PrototypeFive/MLFR_Sensor/README.MD

# MLFR_Sensor 
## (Micro_Laser_Filament_Runout_Sensor)

MLFR_Sensor is 3D printer filament runout sensor based on VCNT2030 Reflective Optical sensor.\
It uses microscopic IR laser and a phototransistor to detect transparent and less reflective materials.

**Supply voltage:** 5V

**Logic:** Active Low

### Print the enclosure:
Use 0.2mm layer height, 2-3 perimeters and 30% infill.<br/>
Print enclosure base with black PLA or PETG.<br/>
Position vertical, like on image. It's important, because the geometry inside diffuses the laser.<br/>
There is a sacrifical layer to be removed.<br/>
Print cover with transparent PLA or PETG, position flat on bed.<br/> 

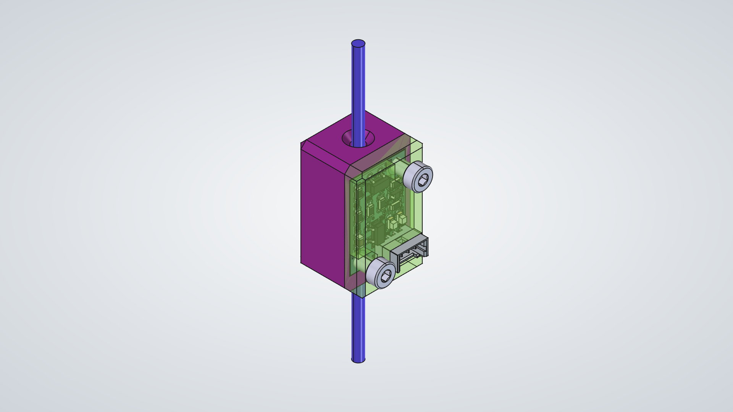
[picture p1: enclosure_2.png]
sensor


License: CERN-OHL-S version 2
