PrototypeFive/MLFR_Sensor/enclosure/enclosure.FCStd

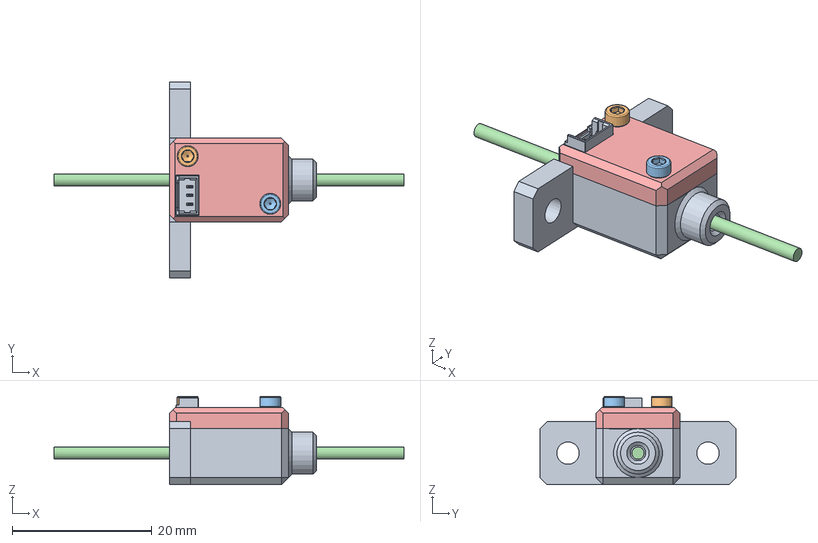
[picture p3: CAD file, 2026-01-30]
enclosure/enclosure.FCStd
50.0 x 28.0 x 12.6 mm
base
M1.6x6-Screw
M1.6x6-Screw002
filament
cover
R_0603_1608Metric
R_0603_1608Metric001
R_0603_1608Metric002
SOT-23
LED_0603_1608Metric
R_0603_1608Metric003
D_0603_1608Metric
R_0603_1608Metric004
SOT-001
LED_0603_1608Metric001
R_0603_1608Metric005
CI44-BASE-DIP_3
CI44-T-DIP
CI44-T-DIP001
CI44-T-DIP002
C_0603_1608Metric
alt_2_copper
alt_2_pad
alt_2_via
alt_2_silkscreen
alt_2_soldermask
alt_2_PCB
