PrototypeFive/MLFR_Sensor/pcb/alt_2.pdf

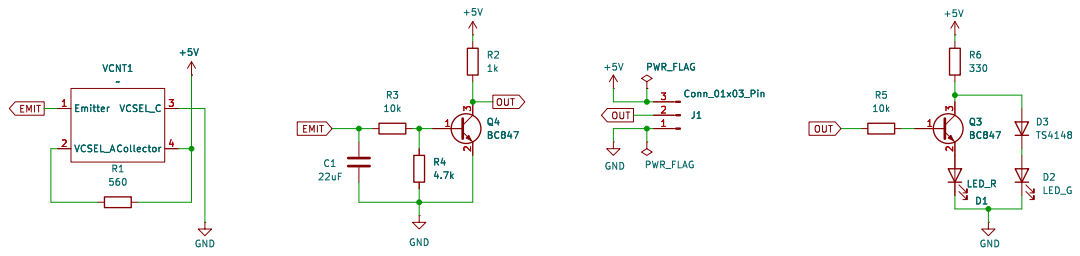
[picture p4: page 1]

CERN-OHL-S-2.0
Id: 1/1 Title: MLFR_Sensor File: alt_2.kicad_sch Sheet: / www.prototypefive.com
