PrototypeFive/MLFR_Sensor/pcb/alt_2.kicad_pcb

## KiCad design pcb/alt_2.kicad_pcb (2026-01-30)

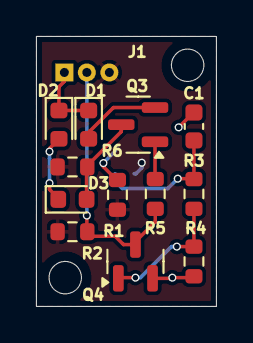
[picture p5: board alt_2.kicad_pcb from above]

Board: 2 copper layers, 10.0 x 15.0 mm, 14 parts (1 on the bottom side), 10 nets.

Parts:
C1: 22uF; C_0603_1608Metric
D1: LED_R; LED_0603_1608Metric
D2: LED_G; LED_0603_1608Metric
D3: TS4148; D_0603_1608Metric
J1: Conn_01x03_Pin; Conn_3p_1.25mm
Q3, Q4: BC847; SOT-23
R1: 560; R_0603_1608Metric
R2: 1k; R_0603_1608Metric
R3, R5: 10k; R_0603_1608Metric
R4: 4.7k; R_0603_1608Metric
R6: 330; R_0603_1608Metric
VCNT1: vcnt2030

Connections:
+5V: J1.3, R1.2, R2.1, R6.1, VCNT1.4 (Collector)
EMIT: C1.2, R3.1, VCNT1.1 (Emitter)
GND: C1.1, D1.1 (K), D2.1 (K), J1.1, Q4.2 (E), R4.2, VCNT1.3 (VCSEL_C)
unnamed: D1.2 (A), Q3.2 (E)
unnamed: D2.2 (A), D3.1 (K)
unnamed: D3.2 (A), Q3.3 (C), R6.2
unnamed: Q3.1 (B), R5.2
unnamed: Q4.1 (B), R3.2, R4.1
unnamed: R1.1, VCNT1.2 (VCSEL_A)
OUT: J1.2, Q4.3 (C), R2.2, R5.1
